rallekralle11/rp-gameboy-cartridge-hw/README.md

I had the idea to add the option to mount the USB port completely internally as well so it looks more "elegant".
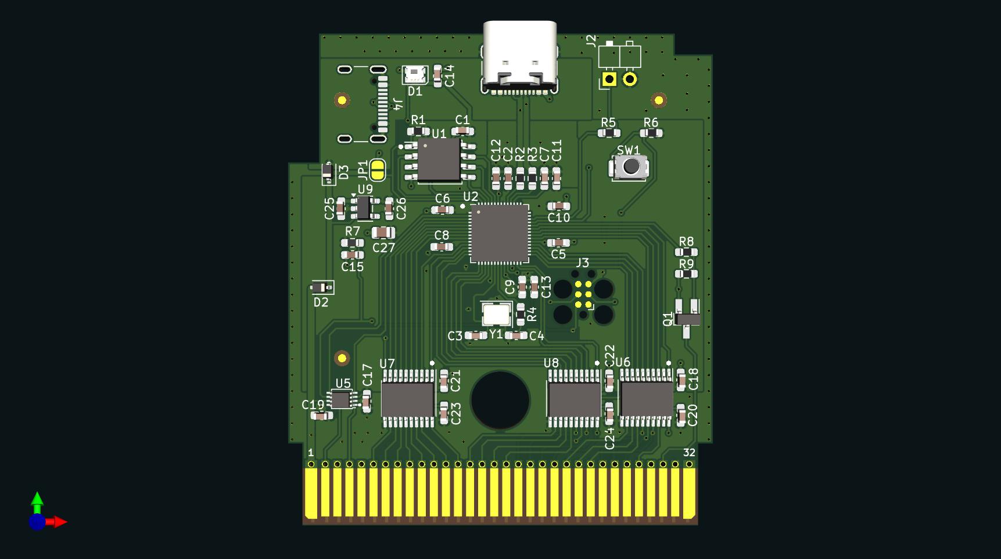
[picture p1: GameboyCartridgeV1.1.jpg]
