rallekralle11/rp-gameboy-cartridge-hw/KiCad/V2/GameboyCartridgeV2.1/CrovoV2.step/RP2350_QFN80.step

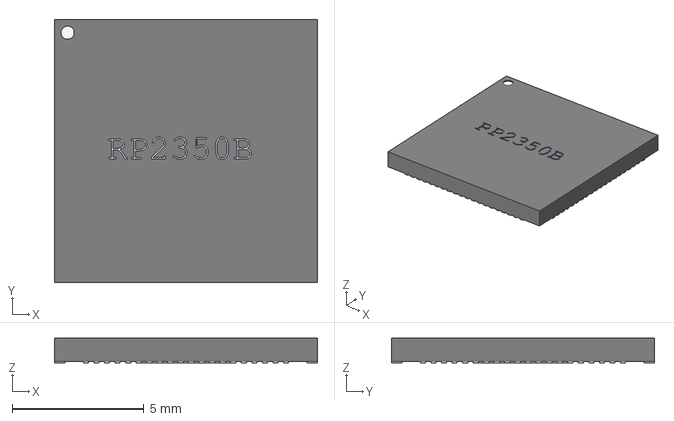
[picture p2: CAD file, 2025-07-16]
KiCad/V2/GameboyCartridgeV2.1/CrovoV2.step/RP2350_QFN80.step
10.0 x 10.0 x 0.95 mm
