rallekralle11/rp-gameboy-cartridge-hw/KiCad/V2/GameboyCartridgeV2.1/CrovoV2.step/PTS810 SJK 250 SMTR LFS--3DModel-STEP-1.STEP

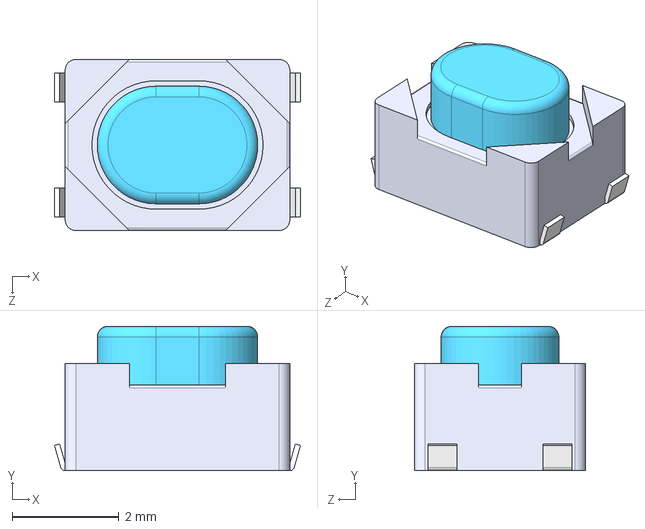
[picture p3: CAD file, 2025-07-16]
KiCad/V2/GameboyCartridgeV2.1/CrovoV2.step/PTS810 SJK 250 SMTR LFS--3DModel-STEP-1.STEP
4.60 x 2.70 x 3.20 mm
