rallekralle11/rp-gameboy-cartridge-hw/KiCad/V2/GameboyCartridgeV2.1/CrovoV2.step/TFBGA24_6X8_WIN.step

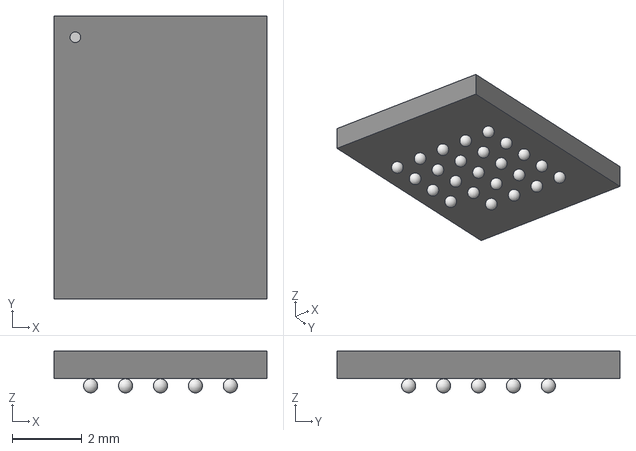
[picture p4: CAD file, 2025-07-16]
KiCad/V2/GameboyCartridgeV2.1/CrovoV2.step/TFBGA24_6X8_WIN.step
6.10 x 8.10 x 1.20 mm
