rallekralle11/rp-gameboy-cartridge-hw/KiCad/V2/GameboyCartridgeV2.1/CrovoV2.step/ESD8008MUTAG.step

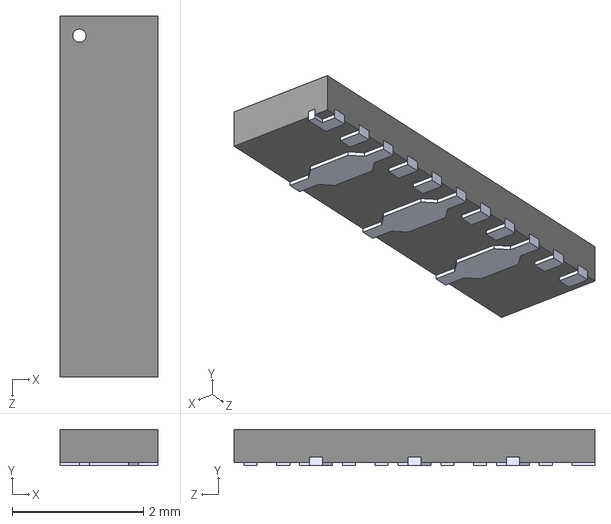
[picture p5: CAD file, 2025-07-16]
KiCad/V2/GameboyCartridgeV2.1/CrovoV2.step/ESD8008MUTAG.step
1.50 x 0.55 x 5.50 mm
