rallekralle11/rp-gameboy-cartridge-hw/KiCad/V2/GameboyCartridgeV2.1/GameboyCartridgeV2.1.kicad_pcb

## KiCad design KiCad/V2/GameboyCartridgeV2.1/GameboyCartridgeV2.1.kicad_pcb (2025-07-16)

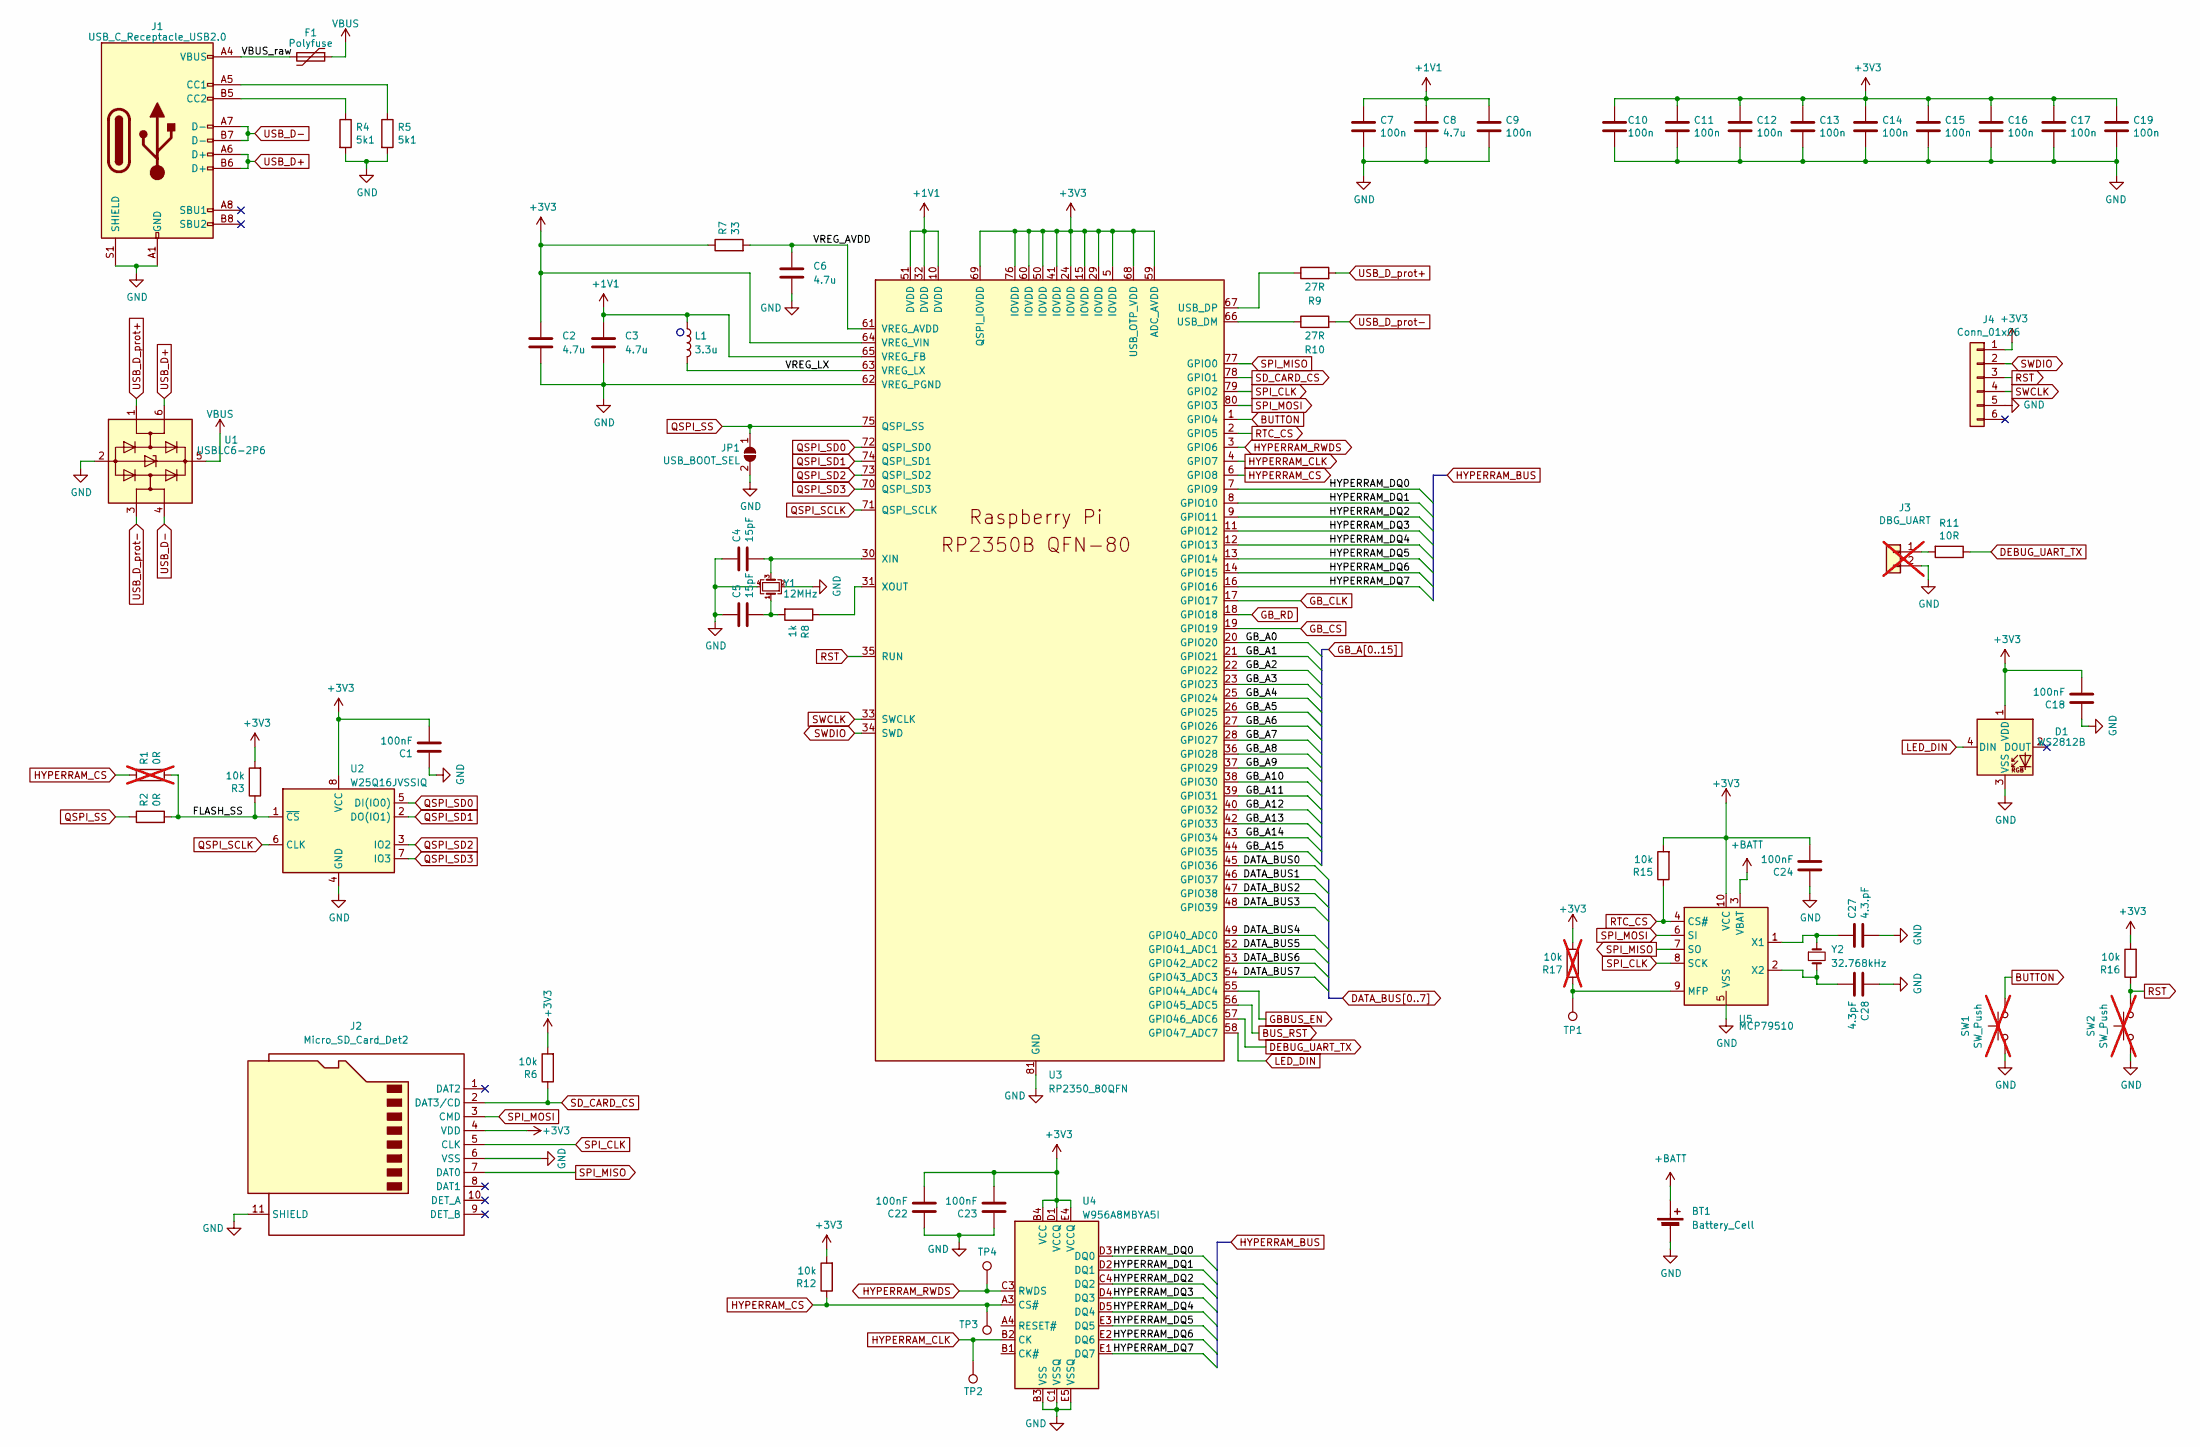
[picture p9: schematic cpu.kicad_sch]

Parts:
BT1: Battery_Cell; BatteryHolder_Keystone_3000_1x12mm; LCSC C6997853
C1, C18, C22, C23, C24: 100nF; C_0603_1608Metric
C2, C3: 4.7u; C_0402_1005Metric_small_pads
C4, C5: 15pF; C_0603_1608Metric; LCSC C1644
C6, C8: 4.7u; C_0402_1005Metric
C7, C9, C10, C11, C12, C13, C14, C15, C16, C17, C19: 100n; C_0402_1005Metric
C27: 4.3.pF; C_0603_1608Metric; LCSC C1644
C28: 4.3pF; C_0603_1608Metric; LCSC C1644
D1: WS2812B; LED_WS2812B_PLCC4_5.0x5.0mm_P3.2mm; LCSC C2761795
F1: Polyfuse; Fuse_1206_3216Metric; LCSC C2649911
J1: USB_C_Receptacle_USB2.0; USB_C_Receptacle_GCT_USB4105-xx-A_16P_TopMnt_Horizontal; LCSC C2927037
J2: Micro_SD_Card_Det2; microSD_HC_Hirose_DM3D-SF; LCSC C719027
J3: DBG_UART; PinHeader_1x02_P2.54mm_Horizontal; not fitted
J4: Conn_01x06; Tag-Connect_TC2030-IDC-NL_2x03_P1.27mm_Vertical
JP1: USB_BOOT_SEL; SolderJumper-2_P1.3mm_Open_RoundedPad1.0x1.5mm
L1: 3.3u; L_pol_2016; LCSC C42411119
R1: 0R; R_0603_1608Metric; not fitted
R2: 0R; R_0603_1608Metric
R3, R6, R12, R15, R16: 10k; R_0603_1608Metric
R4, R5: 5k1; R_0603_1608Metric
R7: 33; R_0402_1005Metric
R8: 1k; R_0603_1608Metric
R9, R10: 27R; R_0603_1608Metric
R11: 10R; R_0603_1608Metric
R17: 10k; R_0603_1608Metric; not fitted
SW1: SW_Push; GameBoy_soft_button; not fitted
SW2: SW_Push; SW_SPST_PTS810; not fitted
TP1, TP2, TP3, TP4: TestPoint; TestPoint_Pad_D1.0mm
U1: USBLC6-2P6; SOT-666; LCSC C15999
U2: W25Q16JVSSIQ; SOIC-8_5.23x5.23mm_P1.27mm; LCSC C82317
U3: RP2350_80QFN; RP2350-QFN-80-1EP_10x10_P0.4mm_EP3.4x3.4mm_ThermalVias; LCSC C42415655
U4: W956A8MBYA5I; BGA25C100P5X5_800X600X120N; LCSC C5375118
U5: MCP79510; MSOP-10_3x3mm_P0.5mm; LCSC C627708
Y1: 12MHz; Crystal_SMD_TXC_7M-4Pin_3.2x2.5mm; LCSC C668845
Y2: 32.768kHz; Crystal_SMD_TXC_9HT11-2Pin_2.0x1.2mm; LCSC C97602

Connections:
+1V1: C3.1, C7.1, C8.1, C9.1, L1.1, U3.10 (DVDD), U3.32 (DVDD), U3.51 (DVDD), U3.65 (VREG_FB)
+3V3: C1.2, C2.1, C10.1, C11.1, C12.1, C13.1, C14.1, C15.1, C16.1, C17.1, C18.2, C19.1, C22.2, C23.2, C24.2, D1.1 (VDD), J2.4 (VDD), J4.1, R3.2, R6.2, R7.1, R12.2, R15.2, R16.2, R17.2, U2.8 (VCC), U3.5 (IOVDD), U3.15 (IOVDD), U3.24 (IOVDD), U3.29 (IOVDD), U3.41 (IOVDD), U3.50 (IOVDD), U3.59 (ADC_AVDD), U3.60 (IOVDD), U3.64 (VREG_VIN), U3.68 (USB_OTP_VDD), U3.69 (QSPI_IOVDD), U3.76 (IOVDD), U4.B4 (VCC), U4.D1 (VCCQ), U4.E4 (VCCQ), U5.10 (VCC); also elsewhere on the board
+BATT: BT1.1 (+), U5.3 (VBAT)
/CPU/FLASH_SS: R1.2, R2.2, R3.1, U2.1 (~CS)
/CPU/HYPERRAM_DQ0: U3.7 (GPIO9), U4.D3 (DQ0)
/CPU/HYPERRAM_DQ1: U3.8 (GPIO10), U4.D2 (DQ1)
/CPU/HYPERRAM_DQ2: U3.9 (GPIO11), U4.C4 (DQ2)
/CPU/HYPERRAM_DQ3: U3.11 (GPIO12), U4.D4 (DQ3)
/CPU/HYPERRAM_DQ4: U3.12 (GPIO13), U4.D5 (DQ4)
/CPU/HYPERRAM_DQ5: U3.13 (GPIO14), U4.E3 (DQ5)
/CPU/HYPERRAM_DQ6: U3.14 (GPIO15), U4.E2 (DQ6)
/CPU/HYPERRAM_DQ7: U3.16 (GPIO16), U4.E1 (DQ7)
/CPU/VBUS_raw: F1.2, J1.A4 (VBUS), J1.A9 (VBUS), J1.B4 (VBUS), J1.B9 (VBUS)
/CPU/VREG_AVDD: C6.1, R7.2, U3.61 (VREG_AVDD)
/CPU/VREG_LX: L1.2, U3.63 (VREG_LX)
BUS_RST: U3.56 (GPIO45_ADC5); also elsewhere on the board
BUTTON: SW1.1, U3.1 (GPIO4)
DATA_BUS0: U3.45 (GPIO36); also elsewhere on the board
DATA_BUS1: U3.46 (GPIO37); also elsewhere on the board
DATA_BUS2: U3.47 (GPIO38); also elsewhere on the board
DATA_BUS3: U3.48 (GPIO39); also elsewhere on the board
DATA_BUS4: U3.49 (GPIO40_ADC0); also elsewhere on the board
DATA_BUS5: U3.52 (GPIO41_ADC1); also elsewhere on the board
DATA_BUS6: U3.53 (GPIO42_ADC2); also elsewhere on the board
DATA_BUS7: U3.54 (GPIO43_ADC3); also elsewhere on the board
DEBUG_UART_TX: R11.1, U3.57 (GPIO46_ADC6)
GBBUS_EN: U3.55 (GPIO44_ADC4); also elsewhere on the board
GB_A0: U3.20 (GPIO20); also elsewhere on the board
GB_A1: U3.21 (GPIO21); also elsewhere on the board
GB_A2: U3.22 (GPIO22); also elsewhere on the board
GB_A3: U3.23 (GPIO23); also elsewhere on the board
GB_A4: U3.25 (GPIO24); also elsewhere on the board
GB_A5: U3.26 (GPIO25); also elsewhere on the board
GB_A6: U3.27 (GPIO26); also elsewhere on the board
GB_A7: U3.28 (GPIO27); also elsewhere on the board
GB_A8: U3.36 (GPIO28); also elsewhere on the board
GB_A9: U3.37 (GPIO29); also elsewhere on the board
GB_A10: U3.38 (GPIO30); also elsewhere on the board
GB_A11: U3.39 (GPIO31); also elsewhere on the board
GB_A12: U3.40 (GPIO32); also elsewhere on the board
GB_A13: U3.42 (GPIO33); also elsewhere on the board
GB_A14: U3.43 (GPIO34); also elsewhere on the board
GB_A15: U3.44 (GPIO35); also elsewhere on the board
GB_CLK: U3.17 (GPIO17); also elsewhere on the board
GB_CS: U3.19 (GPIO19); also elsewhere on the board
GB_RD: U3.18 (GPIO18); also elsewhere on the board
GND: BT1.2 (-), C1.1, C2.2, C3.2, C4.1, C5.1, C6.2, C7.2, C8.2, C9.2, C10.2, C11.2, C12.2, C13.2, C14.2, C15.2, C16.2, C17.2, C18.1, C19.2, C22.1, C23.1, C24.1, C27.2, C28.1, D1.3 (VSS), J1.A1 (GND), J1.A12 (GND), J1.B1 (GND), J1.B12 (GND), J1.S1 (SHIELD), J2.6 (VSS), J2.11 (SHIELD), J3.2, J4.5, JP1.2 (B), R4.2, R5.2, SW1.2, SW2.2, U1.2 (GND), U2.4 (GND), U3.62 (VREG_PGND), U3.81 (GND), U4.B3 (VSS), U4.C1 (VSSQ), U4.E5 (VSSQ), U5.5 (VSS), Y1.2, Y1.4; also elsewhere on the board
HYPERRAM_CLK: TP2.1, U3.4 (GPIO7), U4.B2 (CK)
HYPERRAM_CS: R1.1, R12.1, TP3.1, U3.6 (GPIO8), U4.A3 (CS#)
HYPERRAM_RWDS: TP4.1, U3.3 (GPIO6), U4.C3 (RWDS)
LED_DIN: D1.4 (DIN), U3.58 (GPIO47_ADC7)
unnamed: C5.2, R8.2, Y1.1
unnamed: J1.A5 (CC1), R5.1
unnamed: J1.B5 (CC2), R4.1
unnamed: J3.1, R11.2
unnamed: R10.1, U3.66 (USB_DM)
unnamed: R9.1, U3.67 (USB_DP)
unnamed: C4.2, U3.30 (XIN), Y1.3
unnamed: R8.1, U3.31 (XOUT)
unnamed: R17.1, TP1.1, U5.9 (MFP)
unnamed: C27.1, U5.1 (X1), Y2.1
unnamed: C28.2, U5.2 (X2), Y2.2
QSPI_SCLK: U2.6 (CLK), U3.71 (QSPI_SCLK)
QSPI_SD0: U2.5 (DI(IO0)), U3.72 (QSPI_SD0)
QSPI_SD1: U2.2 (DO(IO1)), U3.74 (QSPI_SD1)
QSPI_SD2: U2.3 (IO2), U3.73 (QSPI_SD2)
QSPI_SD3: U2.7 (IO3), U3.70 (QSPI_SD3)
QSPI_SS: JP1.1 (A), R2.1, U3.75 (QSPI_SS)
RST: J4.3, R16.1, SW2.1, U3.35 (RUN)
RTC_CS: R15.1, U3.2 (GPIO5), U5.4 (CS#)
SD_CARD_CS: J2.2 (DAT3/CD), R6.1, U3.78 (GPIO1)
SPI_CLK: J2.5 (CLK), U3.79 (GPIO2), U5.8 (SCK)
SPI_MISO: J2.7 (DAT0), U3.77 (GPIO0), U5.7 (SO)
SPI_MOSI: J2.3 (CMD), U3.80 (GPIO3), U5.6 (SI)
SWCLK: J4.4, U3.33 (SWCLK)
SWDIO: J4.2, U3.34 (SWD)
USB_D+: J1.A6 (D+), J1.B6 (D+), U1.6 (I/O1)
USB_D-: J1.A7 (D-), J1.B7 (D-), U1.4 (I/O2)
USB_D_prot+: R9.2, U1.1 (I/O1)
USB_D_prot-: R10.2, U1.3 (I/O2)
VBUS: F1.1, U1.5 (VBUS); also elsewhere on the board

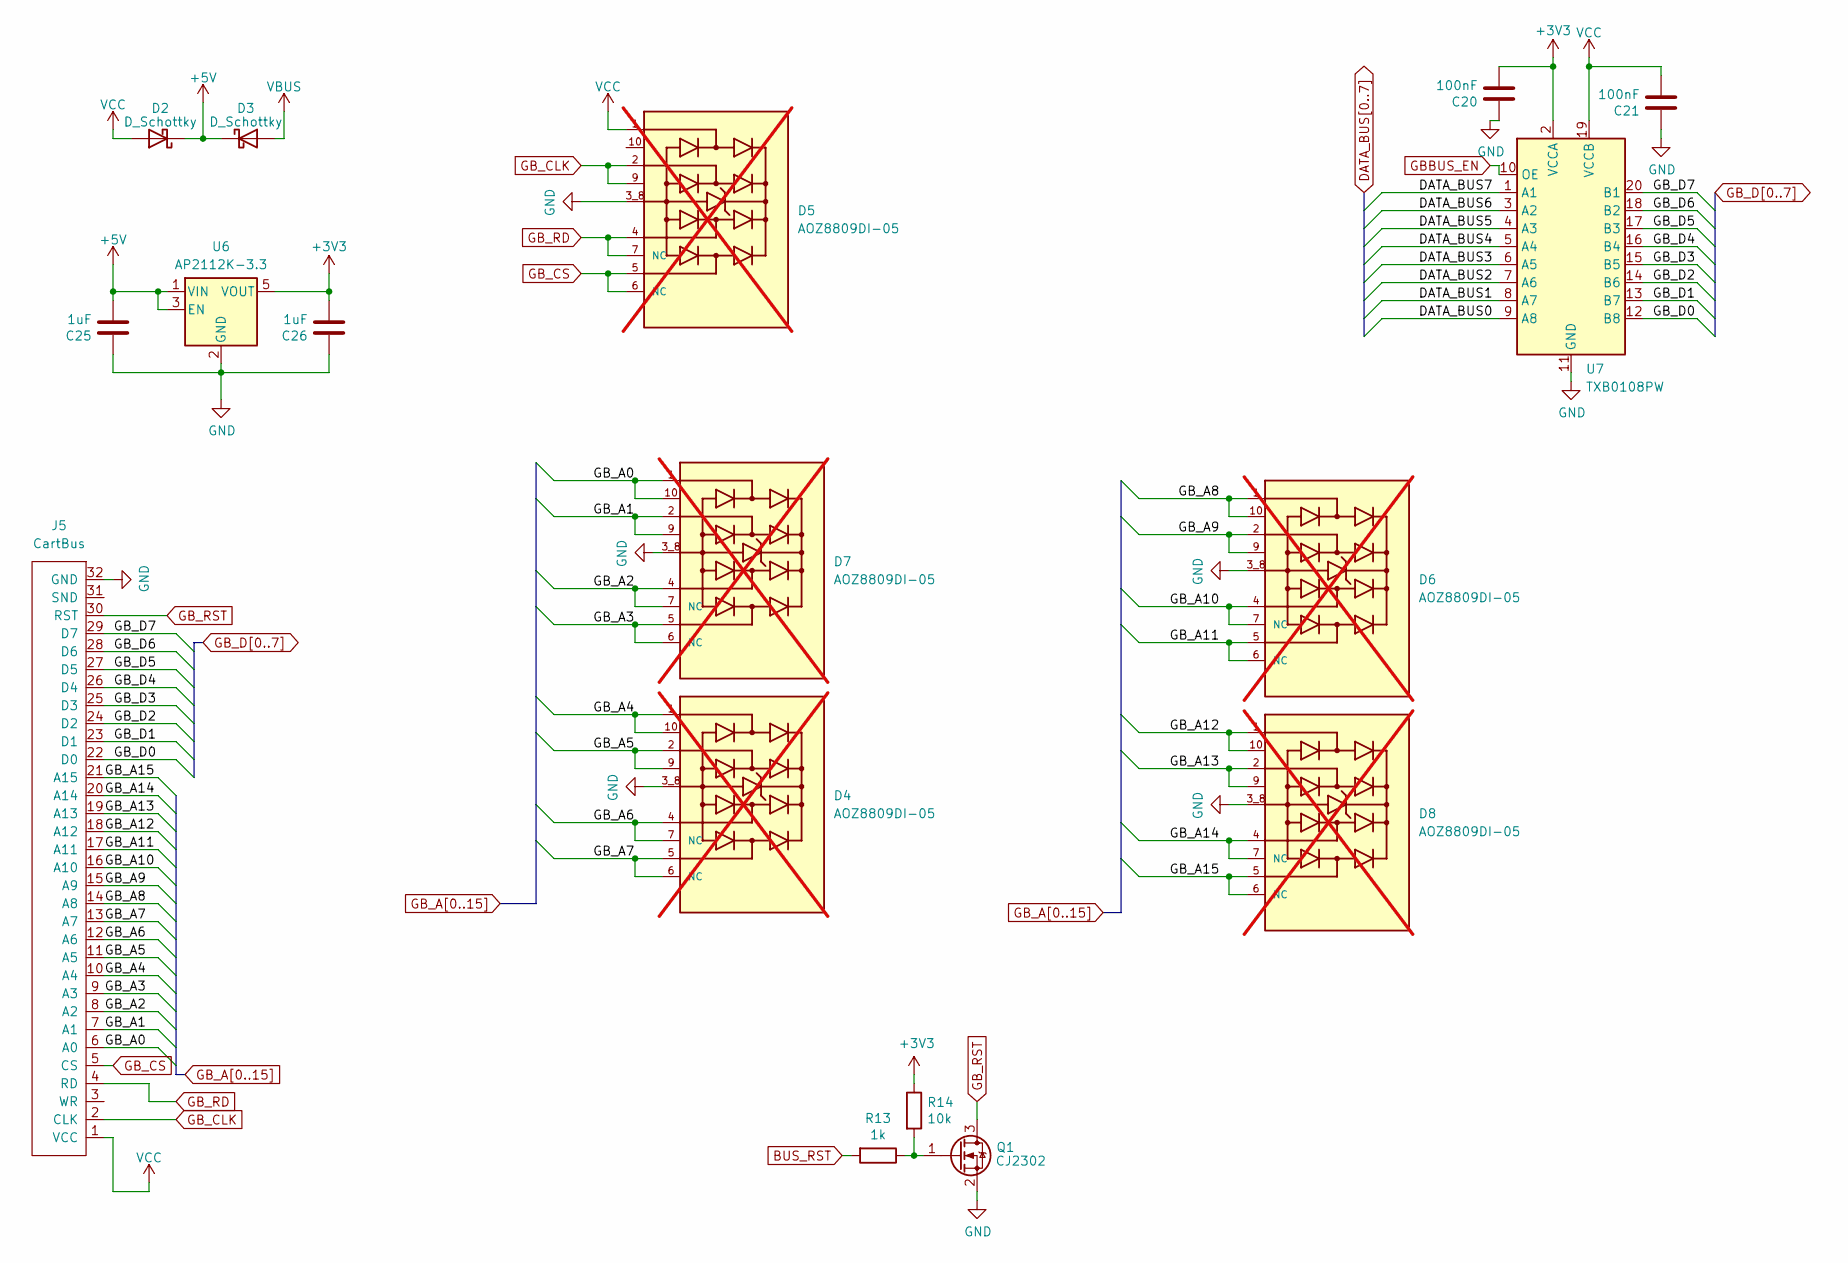
[picture p10: schematic power.kicad_sch]

Parts:
C20, C21: 100nF; C_0603_1608Metric
C25, C26: 1uF; C_0603_1608Metric
D2, D3: D_Schottky; D_SOD-123F; LCSC C669022
D4, D5, D6, D7, D8: AOZ8809DI-05; TVS_AOZ8809DI-05; PARTREV Rev. 7.0; not fitted
J5: CartBus; GameBoy_Cartridge_EdgeConnector
Q1: CJ2302; SOT-23; LCSC C8548
R13: 1k; R_0603_1608Metric
R14: 10k; R_0603_1608Metric
U6: AP2112K-3.3; SOT-23-5; LCSC C51118
U7: TXB0108PW; TSSOP-20_4.4x6.5mm_P0.65mm; LCSC C53406

Connections:
+3V3: C20.2, C26.2, R14.1, U6.5 (VOUT), U7.2 (VCCA); also elsewhere on the board
+5V: C25.2, D2.1 (K), D3.1 (K), U6.1 (VIN), U6.3 (EN)
BUS_RST: R13.2; also elsewhere on the board
DATA_BUS0: U7.9 (A8); also elsewhere on the board
DATA_BUS1: U7.8 (A7); also elsewhere on the board
DATA_BUS2: U7.7 (A6); also elsewhere on the board
DATA_BUS3: U7.6 (A5); also elsewhere on the board
DATA_BUS4: U7.5 (A4); also elsewhere on the board
DATA_BUS5: U7.4 (A3); also elsewhere on the board
DATA_BUS6: U7.3 (A2); also elsewhere on the board
DATA_BUS7: U7.1 (A1); also elsewhere on the board
GBBUS_EN: U7.10 (OE); also elsewhere on the board
GB_A0: D7.1, D7.10, J5.6 (A0); also elsewhere on the board
GB_A1: D7.2, D7.9, J5.7 (A1); also elsewhere on the board
GB_A2: D7.4, D7.7 (NC), J5.8 (A2); also elsewhere on the board
GB_A3: D7.5, D7.6 (NC), J5.9 (A3); also elsewhere on the board
GB_A4: D4.1, D4.10, J5.10 (A4); also elsewhere on the board
GB_A5: D4.2, D4.9, J5.11 (A5); also elsewhere on the board
GB_A6: D4.4, D4.7 (NC), J5.12 (A6); also elsewhere on the board
GB_A7: D4.5, D4.6 (NC), J5.13 (A7); also elsewhere on the board
GB_A8: D6.1, D6.10, J5.14 (A8); also elsewhere on the board
GB_A9: D6.2, D6.9, J5.15 (A9); also elsewhere on the board
GB_A10: D6.4, D6.7 (NC), J5.16 (A10); also elsewhere on the board
GB_A11: D6.5, D6.6 (NC), J5.17 (A11); also elsewhere on the board
GB_A12: D8.1, D8.10, J5.18 (A12); also elsewhere on the board
GB_A13: D8.2, D8.9, J5.19 (A13); also elsewhere on the board
GB_A14: D8.4, D8.7 (NC), J5.20 (A14); also elsewhere on the board
GB_A15: D8.5, D8.6 (NC), J5.21 (A15); also elsewhere on the board
GB_CLK: D5.2, D5.9, J5.2 (CLK~); also elsewhere on the board
GB_CS: D5.5, D5.6 (NC), J5.5 (CS); also elsewhere on the board
GB_D0: J5.22 (D0), U7.12 (B8)
GB_D1: J5.23 (D1), U7.13 (B7)
GB_D2: J5.24 (D2), U7.14 (B6)
GB_D3: J5.25 (D3), U7.15 (B5)
GB_D4: J5.26 (D4), U7.16 (B4)
GB_D5: J5.27 (D5), U7.17 (B3)
GB_D6: J5.28 (D6), U7.18 (B2)
GB_D7: J5.29 (D7), U7.20 (B1)
GB_RD: D5.4, D5.7 (NC), J5.4 (RD); also elsewhere on the board
GB_RST: J5.30 (RST), Q1.3 (D)
GND: C20.1, C21.1, C25.1, C26.1, D4.3_8, D5.3_8, D6.3_8, D7.3_8, D8.3_8, J5.32 (GND), Q1.2 (S), U6.2 (GND), U7.11 (GND); also elsewhere on the board
unnamed: Q1.1 (G), R13.1, R14.2
VBUS: D3.2 (A); also elsewhere on the board
VCC: C21.2, D2.2 (A), D5.1, J5.1 (VCC), U7.19 (VCCB)
