rallekralle11/rp-gameboy-cartridge-hw/KiCad/V2/GameboyCartridgeV2.1/GameboyCartridgeV2.1.kicad_pcb

## KiCad design KiCad/V2/GameboyCartridgeV2.1/GameboyCartridgeV2.1.kicad_pcb (continued)

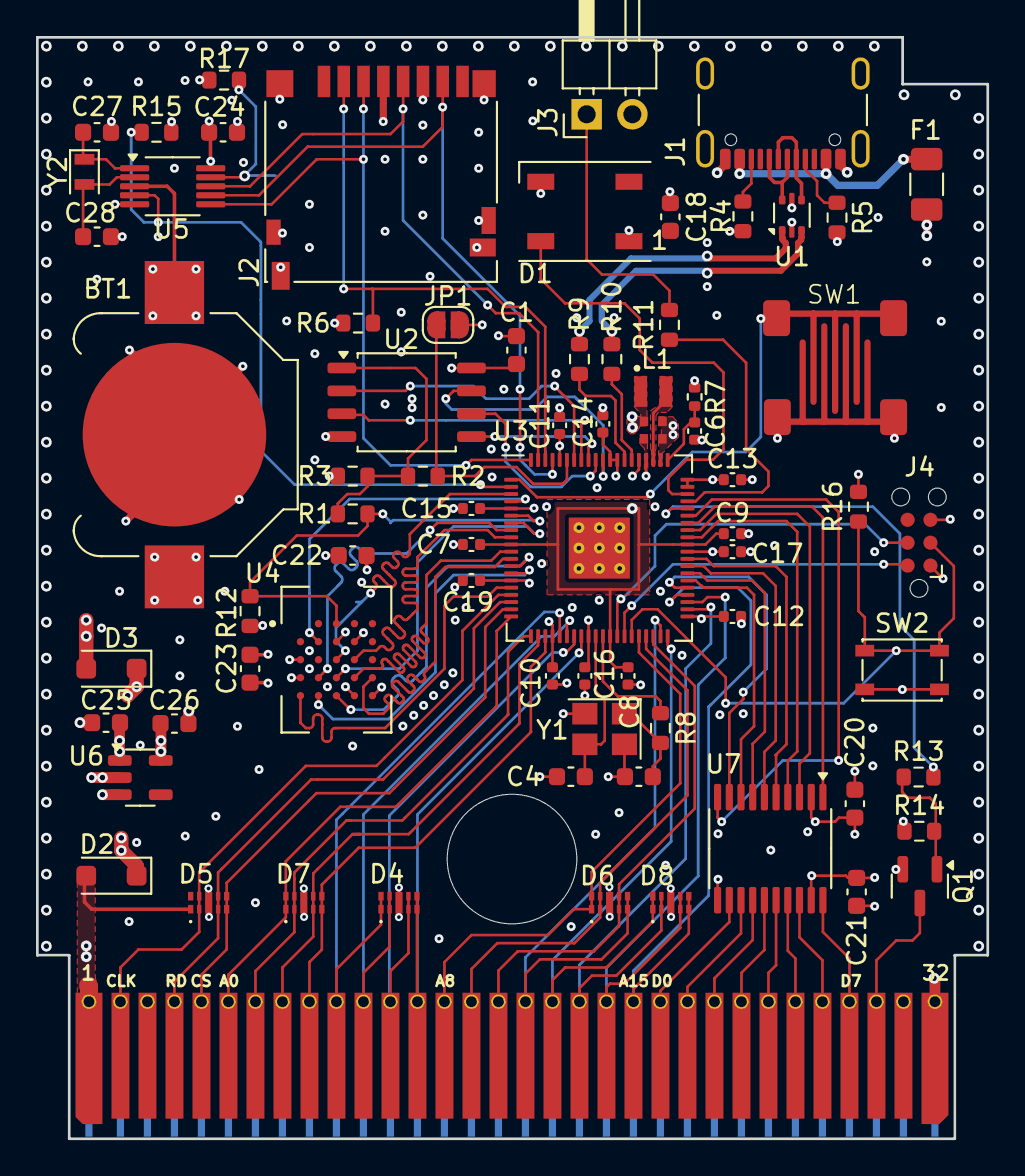
[picture p11: board GameboyCartridgeV2.1.kicad_pcb from above]

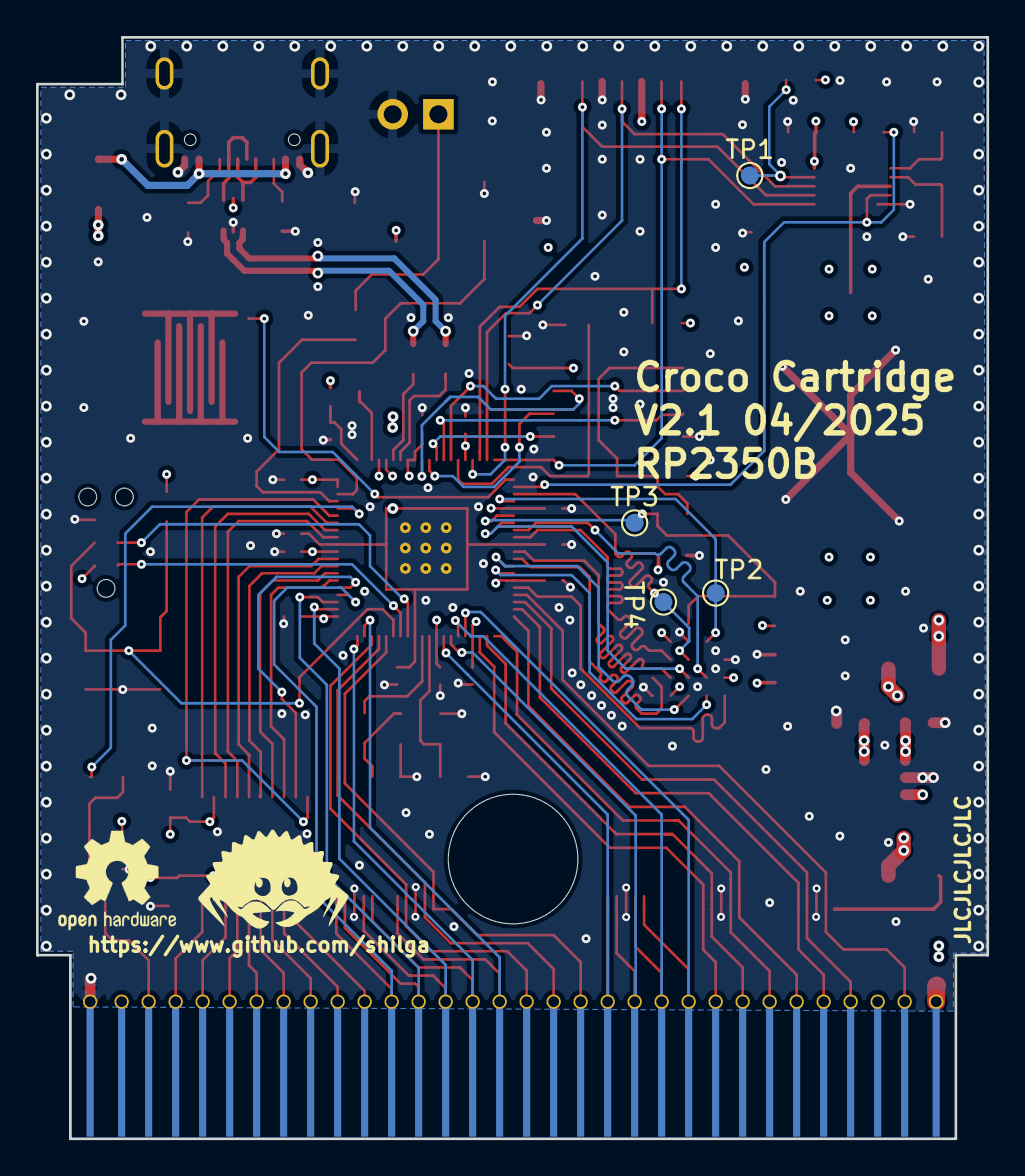
[picture p12: board GameboyCartridgeV2.1.kicad_pcb from below]

Board: 4 copper layers, 52.8 x 61.2 mm, 78 parts (4 on the bottom side), 93 nets.
