rallekralle11/rp-gameboy-cartridge-hw/(commit log)

2025-07-16 Upload V2.1
    [ESD8008MUTAG.step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]
2025-10-24 main changes
    [GameboyCartridgeV1.1-B_Mask.gbs, GameboyCartridgeV1.1-B_Paste.gbp, GameboyCartridgeV1.1-B_Silkscreen.gbo, GameboyCartridgeV1.1-Edge_Cuts.gm1, GameboyCartridgeV1.1-F_Cu.gtl, GameboyCartridgeV1.1-F_Mask.gts, GameboyCartridgeV1.1-F_Paste.gtp, GameboyCartridgeV1.1-F_Silkscreen.gto]
2025-10-24 usb port placement
    [GameboyCartridgeV1.1.kicad_pcb, digital.kicad_sch]
